Daft-Freak/pico-gba-cart/hw/rp2040/gba-cart.kicad_pcb

## KiCad design hw/rp2040/gba-cart.kicad_pcb (2025-03-29)

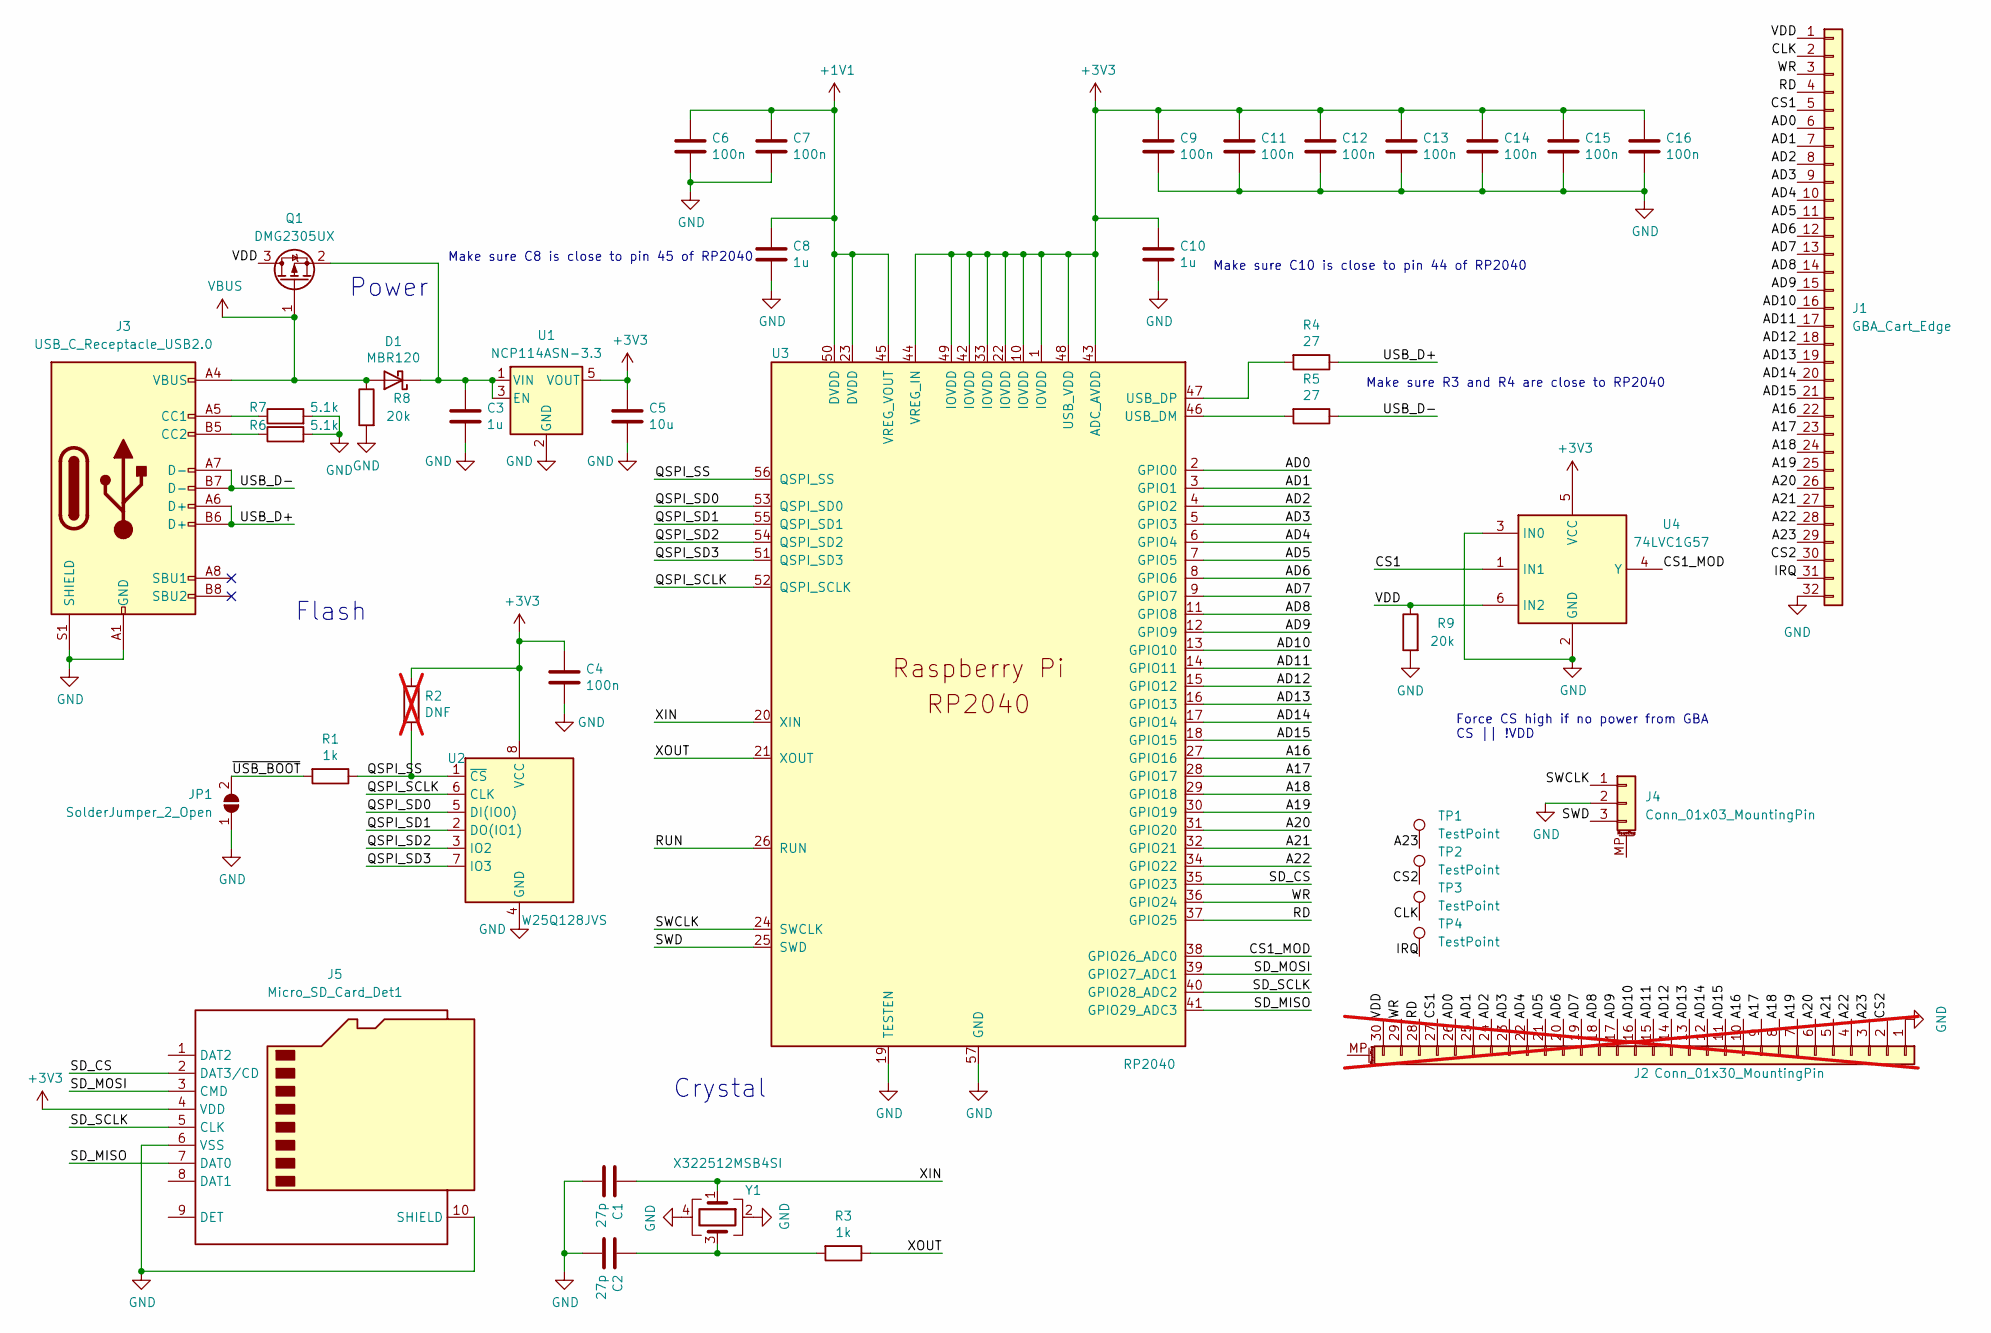
[picture p1: schematic gba-cart.kicad_sch]

Parts:
C1, C2: 27p; C_0402_1005Metric
C3: 1u; C_0805_2012Metric
C4, C6, C7, C9, C11, C12, C13, C14, C15, C16: 100n; C_0402_1005Metric
C5: 10u; C_0805_2012Metric
C8, C10: 1u; C_0402_1005Metric
D1: MBR120; MBR120_SOD-123
J1: GBA_Cart_Edge
J2: Conn_01x30_MountingPin; JUSHUO_AFC01-S30FCA-00_1x30-1MP_P0.50mm_Horizontal; not fitted
J3: USB_C_Receptacle_USB2.0; USB_C_Receptacle_HRO_TYPE-C-31-M-12
J4: Conn_01x03_MountingPin; JST_SH_SM03B-SRSS-TB_1x03-1MP_P1.00mm_Horizontal
J5: Micro_SD_Card_Det1; microSD_HC_Push
JP1: SolderJumper_2_Open; SolderJumper-2_P1.3mm_Open_Pad1.0x1.5mm
Q1: DMG2305UX; SOT-23
R1, R3: 1k; C_0402_1005Metric
R2: DNF; C_0402_1005Metric; not fitted
R4, R5: 27; C_0402_1005Metric
R6, R7: 5.1k; R_0402_1005Metric
R8, R9: 20k; R_0402_1005Metric
TP1, TP2, TP3, TP4: TestPoint; TestPoint_Pad_1.0x1.0mm
U1: NCP114ASN-3.3; TSOP-5_1.65x3.05mm_P0.95mm
U2: W25Q128JVS; SOIC-8_5.23x5.23mm_P1.27mm
U3: RP2040; RP2040-QFN-56
U4: 74LVC1G57; SOT-23-6
Y1: X322512MSB4SI; Crystal_SMD_3225-4Pin_3.2x2.5mm

Connections:
+1V1: C6.1, C7.1, C8.1, U3.23 (DVDD), U3.45 (VREG_VOUT), U3.50 (DVDD)
+3V3: C4.1, C5.1, C9.1, C10.1, C11.1, C12.1, C13.1, C14.1, C15.1, C16.1, J5.4 (VDD), R2.1, U1.5 (VOUT), U2.8 (VCC), U3.1 (IOVDD), U3.10 (IOVDD), U3.22 (IOVDD), U3.33 (IOVDD), U3.42 (IOVDD), U3.43 (ADC_AVDD), U3.44 (VREG_IN), U3.48 (USB_VDD), U3.49 (IOVDD), U4.5 (VCC)
/A16: J1.22, J2.10, U3.27 (GPIO16)
/A17: J1.23, J2.9, U3.28 (GPIO17)
/A18: J1.24, J2.8, U3.29 (GPIO18)
/A19: J1.25, J2.7, U3.30 (GPIO19)
/A20: J1.26, J2.6, U3.31 (GPIO20)
/A21: J1.27, J2.5, U3.32 (GPIO21)
/A22: J1.28, J2.4, U3.34 (GPIO22)
/A23: J1.29, J2.3, TP1.1
/AD0: J1.6, J2.26, U3.2 (GPIO0)
/AD1: J1.7, J2.25, U3.3 (GPIO1)
/AD2: J1.8, J2.24, U3.4 (GPIO2)
/AD3: J1.9, J2.23, U3.5 (GPIO3)
/AD4: J1.10, J2.22, U3.6 (GPIO4)
/AD5: J1.11, J2.21, U3.7 (GPIO5)
/AD6: J1.12, J2.20, U3.8 (GPIO6)
/AD7: J1.13, J2.19, U3.9 (GPIO7)
/AD8: J1.14, J2.18, U3.11 (GPIO8)
/AD9: J1.15, J2.17, U3.12 (GPIO9)
/AD10: J1.16, J2.16, U3.13 (GPIO10)
/AD11: J1.17, J2.15, U3.14 (GPIO11)
/AD12: J1.18, J2.14, U3.15 (GPIO12)
/AD13: J1.19, J2.13, U3.16 (GPIO13)
/AD14: J1.20, J2.12, U3.17 (GPIO14)
/AD15: J1.21, J2.11, U3.18 (GPIO15)
/CLK: J1.2, TP3.1
/CS1: J1.5, J2.27, U4.1 (IN1)
/CS1_MOD: U3.38 (GPIO26_ADC0), U4.4 (Y)
/CS2: J1.30, J2.2, TP2.1
/IRQ: J1.31, TP4.1
/QSPI_SCLK: U2.6 (CLK), U3.52 (QSPI_SCLK)
/QSPI_SD0: U2.5 (DI(IO0)), U3.53 (QSPI_SD0)
/QSPI_SD1: U2.2 (DO(IO1)), U3.55 (QSPI_SD1)
/QSPI_SD2: U2.3 (IO2), U3.54 (QSPI_SD2)
/QSPI_SD3: U2.7 (IO3), U3.51 (QSPI_SD3)
/QSPI_SS: R1.1, R2.2, U2.1 (~CS), U3.56 (QSPI_SS)
/RD: J1.4, J2.28, U3.37 (GPIO25)
/RUN: U3.26 (RUN)
/SD_CS: J5.2 (DAT3/CD), U3.35 (GPIO23)
/SD_MISO: J5.7 (DAT0), U3.41 (GPIO29_ADC3)
/SD_MOSI: J5.3 (CMD), U3.39 (GPIO27_ADC1)
/SD_SCLK: J5.5 (CLK), U3.40 (GPIO28_ADC2)
/SWCLK: J4.1, U3.24 (SWCLK)
/SWD: J4.3, U3.25 (SWD)
/USB_D+: J3.A6 (D+), J3.B6 (D+), R4.1
/USB_D-: J3.A7 (D-), J3.B7 (D-), R5.1
/VDD: J1.1, J2.30, Q1.3 (D), R9.1, U4.6 (IN2)
/WR: J1.3, J2.29, U3.36 (GPIO24)
/XIN: C1.1, U3.20 (XIN), Y1.1
/XOUT: R3.1, U3.21 (XOUT)
/~USB_BOOT: JP1.2 (B), R1.2
GND: C1.2, C2.2, C3.2, C4.2, C5.2, C6.2, C7.2, C8.2, C9.2, C10.2, C11.2, C12.2, C13.2, C14.2, C15.2, C16.2, J1.32, J3.A1 (GND), J3.A12 (GND), J3.B1 (GND), J3.B12 (GND), J3.S1 (SHIELD), J4.2, J5.6 (VSS), J5.10 (SHIELD), JP1.1 (A), R6.2, R7.2, R8.2, R9.2, U1.2 (GND), U2.4 (GND), U3.19 (TESTEN), U3.57 (GND), U4.2 (GND), U4.3 (IN0), Y1.2, Y1.4
unnamed: C2.1, R3.2, Y1.3
unnamed: C3.1, D1.1 (K), Q1.2 (S), U1.1 (VIN), U1.3 (EN)
unnamed: J3.A5 (CC1), R7.1
unnamed: J3.B5 (CC2), R6.1
unnamed: R5.2, U3.46 (USB_DM)
unnamed: R4.2, U3.47 (USB_DP)
VBUS: D1.2 (A), J3.A4 (VBUS), J3.A9 (VBUS), J3.B4 (VBUS), J3.B9 (VBUS), Q1.1 (G), R8.1

Notes on the sheet:
Crystal
Flash
Power
Make sure R3 and R4 are close to RP2040
Force CS high if no power from GBA CS || !VDD
Make sure C10 is close to pin 44 of RP2040
Make sure C8 is close to pin 45 of RP2040

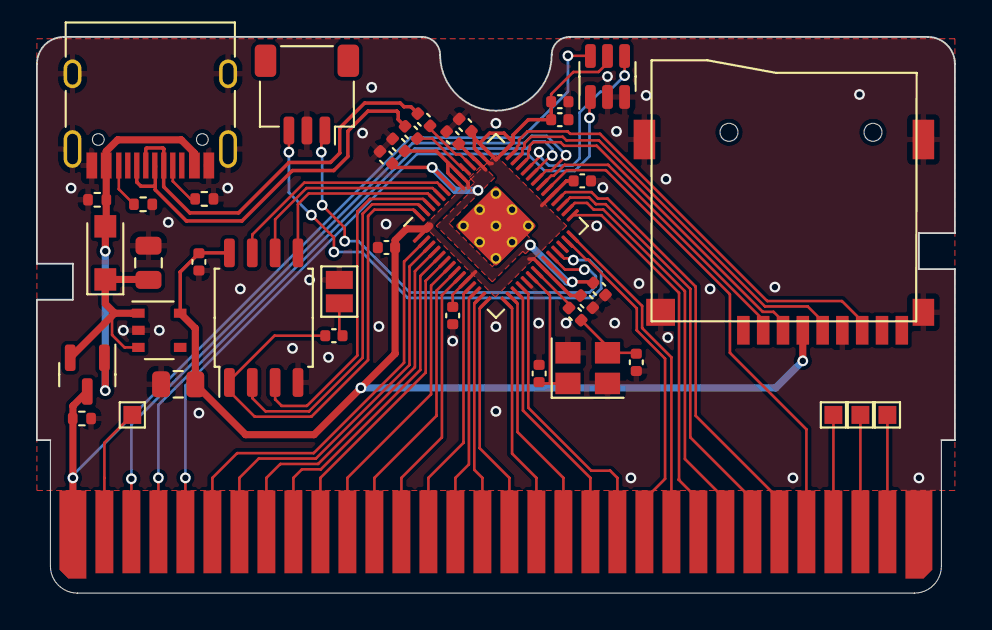
[picture p2: board hw/rp2040/gba-cart.kicad_pcb from above]

Board: 2 copper layers, 51.0 x 30.9 mm, 40 parts (0 on the bottom side), 59 nets.
