Daft-Freak/pico-gba-cart/hw/pga2040/gba-cart.kicad_pcb

## KiCad design hw/pga2040/gba-cart.kicad_pcb (2025-03-29, an earlier design)

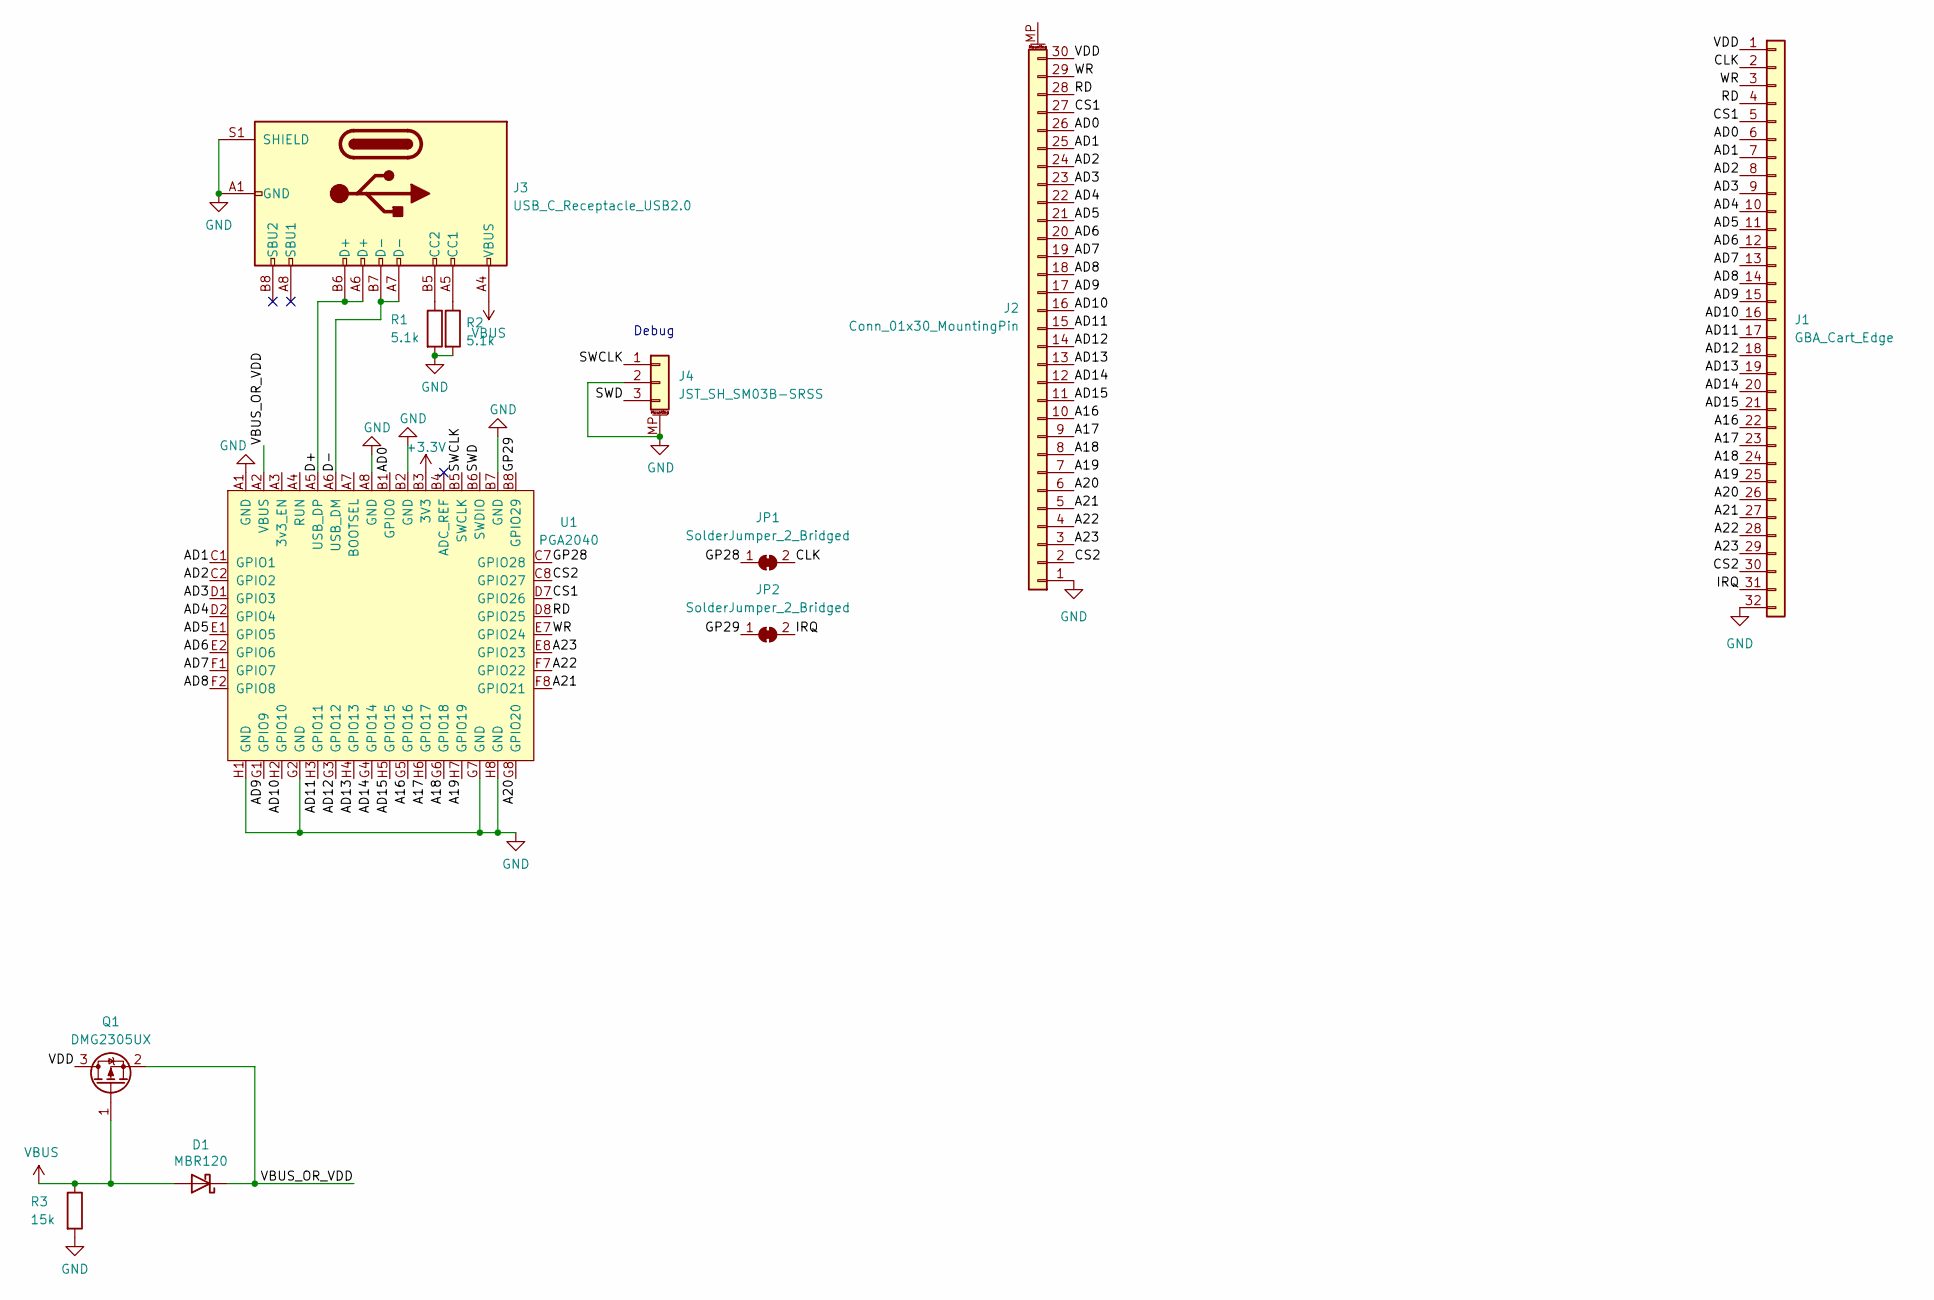
[picture p3: schematic gba-cart.kicad_sch]

Parts:
D1: MBR120; MBR120_SOD-123
J1: GBA_Cart_Edge
J2: Conn_01x30_MountingPin; JUSHUO_AFC01-S30FCA-00_1x30-1MP_P0.50mm_Horizontal
J3: USB_C_Receptacle_USB2.0; USB_C_Receptacle_HRO_TYPE-C-31-M-12
J4: JST_SH_SM03B-SRSS; JST_SH_SM03B-SRSS-TB_1x03-1MP_P1.00mm_Horizontal
JP1, JP2: SolderJumper_2_Bridged; SolderJumper-2_P1.3mm_Bridged_Pad1.0x1.5mm
Q1: DMG2305UX; SOT-23
R1, R2: 5.1k; R_0402_1005Metric
R3: 15k; R_0402_1005Metric
U1: PGA2040; PGA2040_PTH_WITH_SLOT

Connections:
+3V3: U1.B3 (3V3)
/A16: J1.22, J2.10, U1.G5 (GPIO16)
/A17: J1.23, J2.9, U1.H6 (GPIO17)
/A18: J1.24, J2.8, U1.G6 (GPIO18)
/A19: J1.25, J2.7, U1.H7 (GPIO19)
/A20: J1.26, J2.6, U1.G8 (GPIO20)
/A21: J1.27, J2.5, U1.F8 (GPIO21)
/A22: J1.28, J2.4, U1.F7 (GPIO22)
/A23: J1.29, J2.3, U1.E8 (GPIO23)
/AD0: J1.6, J2.26, U1.B1 (GPIO0)
/AD1: J1.7, J2.25, U1.C1 (GPIO1)
/AD2: J1.8, J2.24, U1.C2 (GPIO2)
/AD3: J1.9, J2.23, U1.D1 (GPIO3)
/AD4: J1.10, J2.22, U1.D2 (GPIO4)
/AD5: J1.11, J2.21, U1.E1 (GPIO5)
/AD6: J1.12, J2.20, U1.E2 (GPIO6)
/AD7: J1.13, J2.19, U1.F1 (GPIO7)
/AD8: J1.14, J2.18, U1.F2 (GPIO8)
/AD9: J1.15, J2.17, U1.G1 (GPIO9)
/AD10: J1.16, J2.16, U1.H2 (GPIO10)
/AD11: J1.17, J2.15, U1.H3 (GPIO11)
/AD12: J1.18, J2.14, U1.G3 (GPIO12)
/AD13: J1.19, J2.13, U1.H4 (GPIO13)
/AD14: J1.20, J2.12, U1.G4 (GPIO14)
/AD15: J1.21, J2.11, U1.H5 (GPIO15)
/CLK: J1.2, JP1.2 (B)
/CS1: J1.5, J2.27, U1.D7 (GPIO26)
/CS2: J1.30, J2.2, U1.C8 (GPIO27)
/D+: J3.A6 (D+), J3.B6 (D+), U1.A5 (USB_DP)
/D-: J3.A7 (D-), J3.B7 (D-), U1.A6 (USB_DM)
/GP28: JP1.1 (A), U1.C7 (GPIO28)
/GP29: JP2.1 (A), U1.B8 (GPIO29)
/IRQ: J1.31, JP2.2 (B)
/RD: J1.4, J2.28, U1.D8 (GPIO25)
/SWCLK: J4.1, U1.B5 (SWCLK)
/SWD: J4.3, U1.B6 (SWDIO)
/VBUS_OR_VDD: D1.1 (K), Q1.2 (S), U1.A2 (VBUS)
/VDD: J1.1, J2.30, Q1.3 (D)
/WR: J1.3, J2.29, U1.E7 (GPIO24)
GND: J1.32, J2.1, J3.A1 (GND), J3.A12 (GND), J3.B1 (GND), J3.B12 (GND), J3.S1 (SHIELD), J4.2, J4.MP (MountPin), R1.2, R2.2, R3.2, U1.A1 (GND), U1.A8 (GND), U1.B2 (GND), U1.B7 (GND), U1.G2 (GND), U1.G7 (GND), U1.H1 (GND), U1.H8 (GND)
unnamed: J3.A5 (CC1), R2.1
unnamed: J3.B5 (CC2), R1.1
VBUS: D1.2 (A), J3.A4 (VBUS), J3.A9 (VBUS), J3.B4 (VBUS), J3.B9 (VBUS), Q1.1 (G), R3.1

Notes on the sheet:
Debug

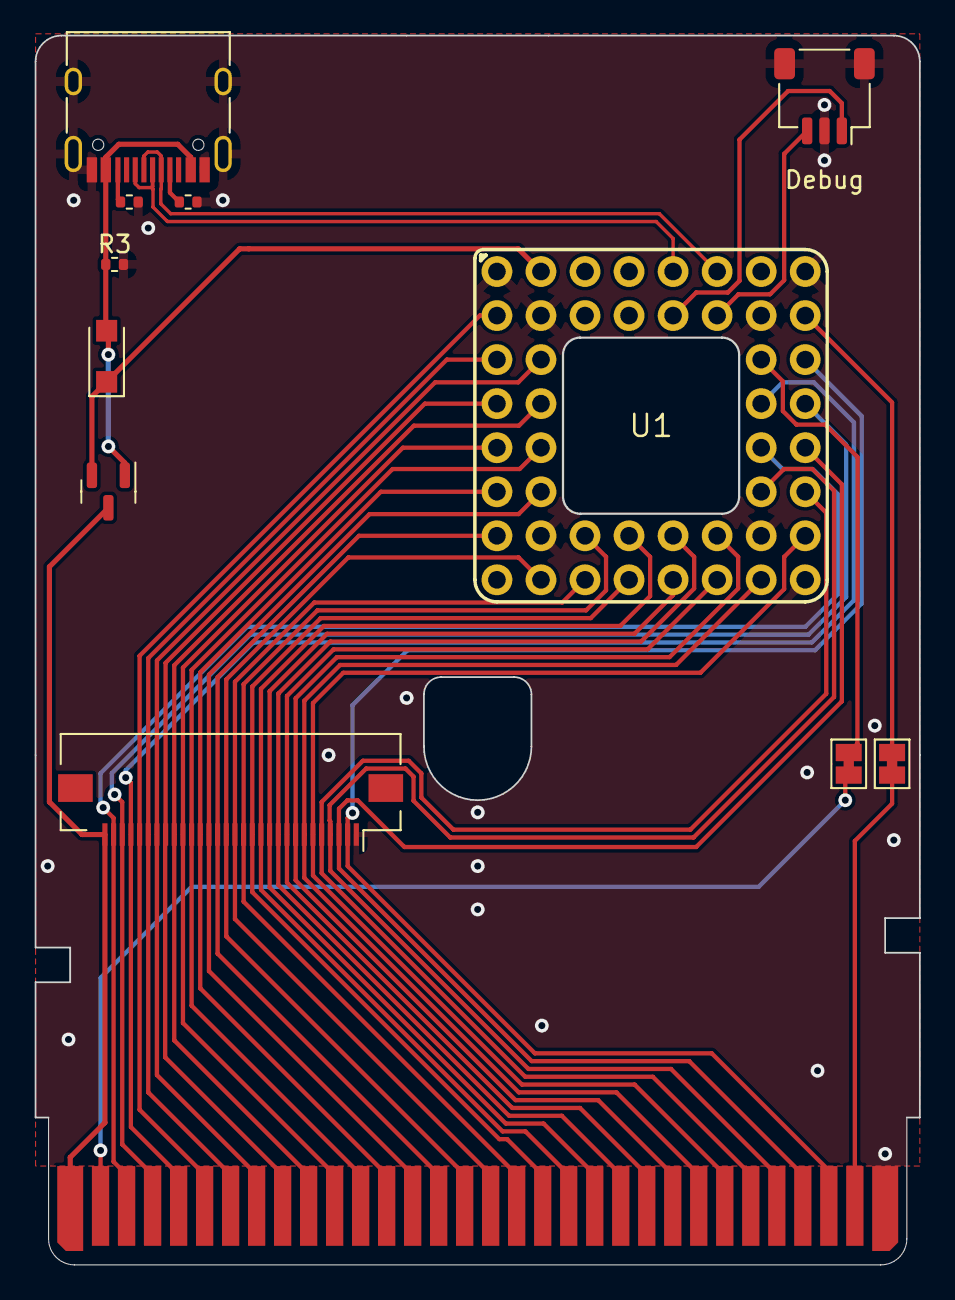
[picture p4: board hw/pga2040/gba-cart.kicad_pcb from above]

Board: 2 copper layers, 51.0 x 70.9 mm, 12 parts (0 on the bottom side), 42 nets.
