Daft-Freak/pico-gba-cart/(commit log)

2025-03-29 Add PGA2040 prototype
    [gba-cart.kicad_pcb, gba-cart.kicad_sch]
2025-03-29 Add RP2040-based board
    [gba-cart.kicad_pcb, gba-cart.kicad_sch]
2025-04-02 Add missing include for set_sys_closk_khz
    [main.cpp]
2025-04-02 Deduplicate pin definitions
